andrew-abdelmalak/2-dof-robotic-arm-control-system/docs/Nonlinear_Control_2DOF_Arm.pdf

# Non-Linear Control of a 2-DOF Robotic Arm: Complete Design, Simulation, and Hardware Implementation

Ahmed Mostafa
Dept. of Mechatronics Engineering German University in Cairo (GUC) Cairo, Egypt

Andrew Khalil
Dept. of Mechatronics Engineering German University in Cairo (GUC) Cairo, Egypt

Hazim Ashraf
Dept. of Mechatronics Engineering German University in Cairo (GUC) Cairo, Egypt

Mazen Amr
Dept. of Mechatronics Engineering German University in Cairo (GUC) Cairo, Egypt

Samir Sameh
Dept. of Mechatronics Engineering German University in Cairo (GUC) Cairo, Egypt

Youssef Youssry
Dept. of Mechatronics Engineering German University in Cairo (GUC) Cairo, Egypt

Abstract—This paper presents the complete design, simulation, and hardware implementation of a non-linear controlled two-degree-of-freedom (2-DOF) planar robotic arm. The work encompasses mathematical modeling using the Euler–Lagrange formulation, non-linear stability analysis via Lyapunov methods, feedback linearization control synthesis, MATLAB/Simulink simulation validation, and real-time embedded implementation on an Arduino microcontroller. The system employs two 25GA370 DC gear motors with integrated quadrature encoders, 3D-printed PLA+ structural links designed in SolidWorks, and an L298N dual H-bridge motor driver. The feedback linearization controller decouples the highly non-linear joint dynamics, achieving accurate trajectory tracking across the workspace. Simulation results demonstrate convergent position regulation with less than

### 0.01 rad steady-state error and circular trajectory tracking with

phase error below 0.02 rad. Hardware validation on the physical prototype confirms the practical feasibility of the non-linear control approach for low-cost educational robotic platforms. Index Terms—Non-linear control, robotic manipulator, feedback linearization, Euler–Lagrange, DC motors, embedded systems, MATLAB/Simulink, Arduino, trajectory tracking, Lyapunov stability.

I. INTRODUCTION

Robotic manipulators are indispensable across modern applications including industrial automation, precision manufacturing, medical surgery, and research [1]. Achieving accurate trajectory tracking requires control algorithms that compensate for model uncertainties, disturbances, and the inherent nonlinear coupling between joints.
Manipulators are fundamentally multi-input multi-output (MIMO) systems: each actuator influences the motion of multiple links through configuration-dependent inertia, Coriolis/centrifugal coupling, and gravitational effects. These properties render linear control approaches—such as independent PID loops—inadequate for high-performance operation, especially at moderate to high speeds [2].

Feedback linearization (also called computed-torque control) addresses this by using the system’s known dynamics to construct a control law that exactly cancels the non-linear effects, producing a linearized closed-loop system amenable to classical design techniques [1], [3].
This paper presents the complete engineering workflow for a 2-DOF planar robotic arm:
1) Mathematical modeling using Euler–Lagrange dynamics (Section II).
2) Feedback linearization controller design with Lyapunov stability analysis (Section III).
3) MATLAB/Simulink simulation validation across multiple operational scenarios (Section IV).
4) Hardware implementation using commercially available components and embedded real-time control (Section V).
5) Experimental verification comparing simulation predictions to hardware behavior (Section VI).

II. MATHEMATICAL MODELING AND DYNAMICS

A. Manipulator Dynamics via Euler–Lagrange

Consider a planar 2-DOF arm with joint variables q = [q1, q2]

T
. Each link i has mass mi

, length li
, center-of-mass
distance rci

, and inertia Ii
. The standard manipulator equation is [2]:
M(q)q¨ + C(q, q˙)q˙ + G(q) + Dq˙ = τ | (1)

where M(q) is the symmetric positive-definite inertia matrix, C(q, q˙) contains Coriolis and centrifugal terms, G(q) is the gravity vector, Dq˙ models viscous damping, and τ is the joint torque vector.

The inertia matrix components are:

M11 = I1 + I2 + m1r

2
c1 + m2(l

2
1 + r

2
c2 + 2l1rc2

cos q2) (2)
M12 = I2 + m2(r

2
c2 + l1rc2
cos q2) | (3)
M22 = I2 + m2r

2
c2

(4)

The Coriolis matrix uses h(q) = m2l1rc2 sin q2:

C(q, q˙) =
−hq˙2 | −h( ˙q1 + ˙q2)
hq˙1 | 0
(5)

For the horizontal planar configuration used in this project, G(q) = 0 since gravity acts perpendicular to the plane of motion.

B. DC Motor and Actuator Model
Each joint is driven by a DC gear motor. Applying the electromechanical simplification (L˙i ≈ 0 due to fast electrical dynamics), the relationship between applied voltage u and resulting joint torque is [3]:

τ ≈ αu − βq˙ , α =

NKt
R

, β =

N²KtKe
R

+ NBm (6)

where N is the gear ratio, Kt is the torque constant, Ke is the back-EMF constant, R is the armature resistance, and Bm is the viscous damping.
Substituting into (1) and solving for acceleration:

q¨ = M⁻¹
[αu − Cq˙ − G − (D + β)q˙ ] | (7)

III. CONTROL DESIGN AND STABILITY ANALYSIS

A. Feedback Linearization Controller
The controller computes a reference acceleration incorporating PD feedback on tracking errors e = qd − qm:
q¨r = q¨d + Kpe + Kde˙ | (8)

where Kp, Kd ∈ R

2×2
are diagonal gain matrices.
The linearizing control law computes required torques:

τ des = M(q)q¨r + C(q, q˙)q˙ + G(q) + (D + β)q˙ (9)

Substituting into the dynamics cancels all non-linear terms, yielding q¨ = q¨r. The motor voltages are then:

u = α

−1
(τ des + βq˙) | (10)
B. Lyapunov Stability Analysis Construct the Lyapunov function [4]:

V =
1/2 e

T Kpe +
1/2 e˙

T
e˙ | (11)

Taking the time derivative along trajectories of the error dynamics e¨ + Kde˙ + Kpe = 0:

V˙ = −e˙
T Kde˙ ≤ 0 | (12)

Since Kd is positive-definite, V˙ ≤ 0 with equality only when e˙ = 0. By LaSalle’s invariance principle, tracking errors asymptotically converge to zero.
For critical damping (ζ = 1), the gain relationship is Kd = 2

p
Kp.
C. Pole Placement Verification

The linearized system at equilibrium xeq = 0 was verified using pole placement with desired eigenvalues λ = {−4, −5, −6, −7}. Fig. 1 confirms convergent closed-loop response with all eigenvalues in the left half-plane.

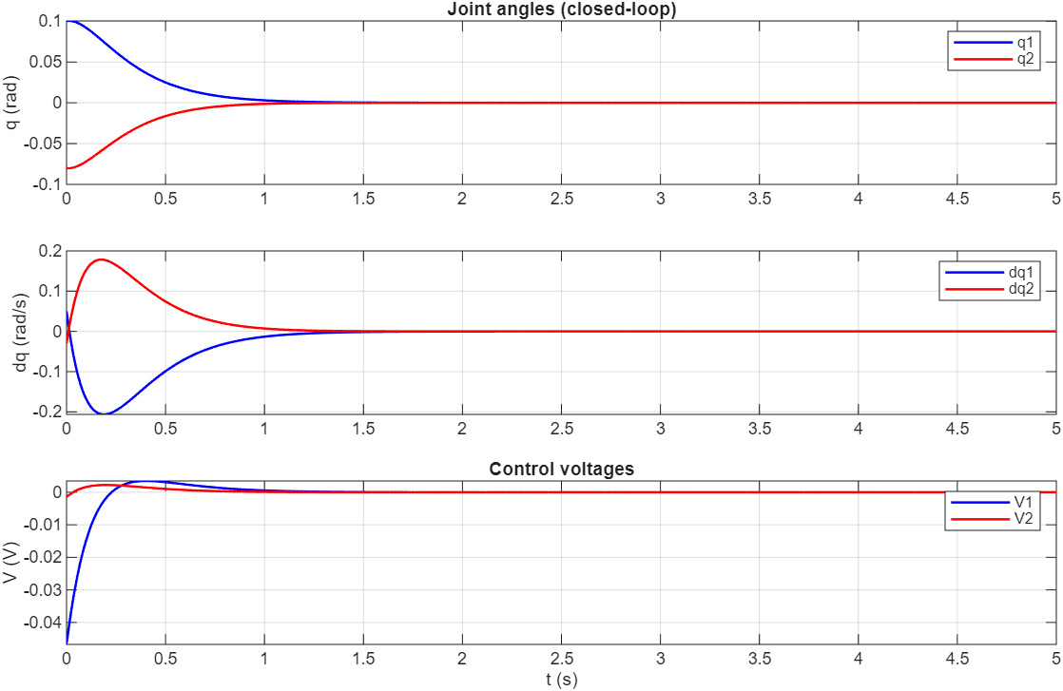
[picture p9: figure]

Fig. 1. Closed-loop equilibrium response: joint angles converge to zero (top), joint velocities decay (middle), and control voltages settle (bottom), confirming asymptotic stability.

IV. SIMULATION RESULTS

A complete non-linear simulation environment was implemented in MATLAB/Simulink with three operational modes managed by a Stateflow state machine (Fig. 2): OFF, Position (POS), and Circle Trajectory (CIRCLE).

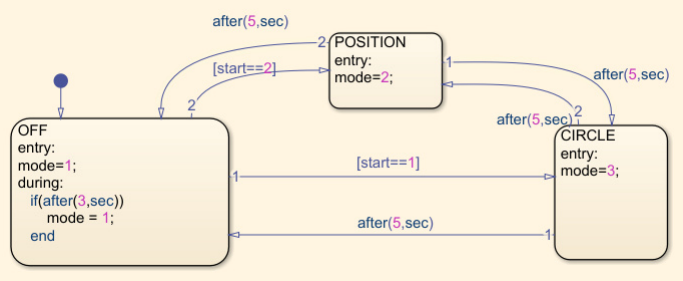
[picture p10: figure]

Fig. 2. Stateflow state machine governing mode transitions: OFF → POSI-TION → CIRCLE, with timed transitions between states.

A. Position Regulation

The robot was commanded to move from qinit = [0, 0] to qd = [0.5, 0.5] rad. Two gain sets were compared:

- Set 1 (Kp, Kd) = (5, 1): Smooth convergence, overshoot ∼0.05 rad, settling time ∼3 s.
- Set 2 (Kp, Kd) = (10, 3): Faster response, overshoot ∼0.01 rad, settling time ∼1.5 s.

Table I summarizes the trade-offs.

TABLE I
EFFECT OF GAIN SELECTION ON SYSTEM RESPONSE
Characteristic | Low Gains | High Gains
Rise time | Slow | Fast
Overshoot | Higher | Lower
Settling time | Long | Short
Control effort | Low | High
Noise sensitivity | Low | High
Robustness | High | Moderate
B. Circular Trajectory Tracking

The end-effector was commanded to trace a circle of radius R = 0.3 m at ω = 0.5 rad/s. Fig. 3 shows the joint angle tracking performance: measured angles track desired references with phase error < 0.02 rad and amplitude error < 1%.

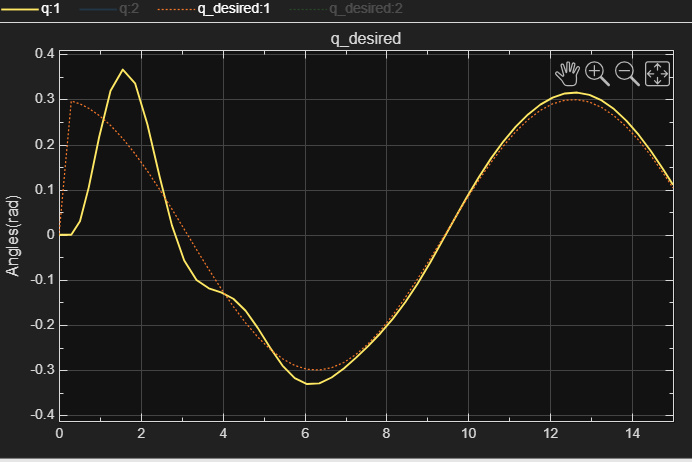
[picture p11: figure]

Fig. 3. Circular trajectory tracking: measured joint angles (solid) closely follow desired references (dashed) with minimal phase lag after initial transient.

C. Hybrid Mode (Position → Trajectory)

The full hybrid sequence (OFF → POS → CIRCLE) demonstrates seamless mode transitions (Fig. 4): position regulation during 1–6 s followed by smooth transition to circular tracking.

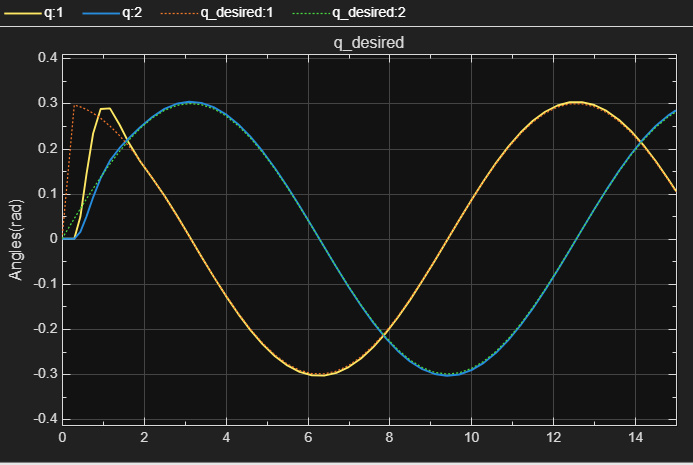
[picture p12: figure]

Fig. 4. Hybrid mode response showing sequential position regulation (1–6 s) and circular trajectory tracking (6+ s). The controller successfully manages mode transitions without destabilizing transients.

V. HARDWARE IMPLEMENTATION
A. Motor Selection
The 25GA370 DC gear motor with integrated quadrature encoder (Fig. 5) was selected for its favorable combination of torque capacity, encoder feedback, and direct voltage controllability. Table II summarizes its key specifications.

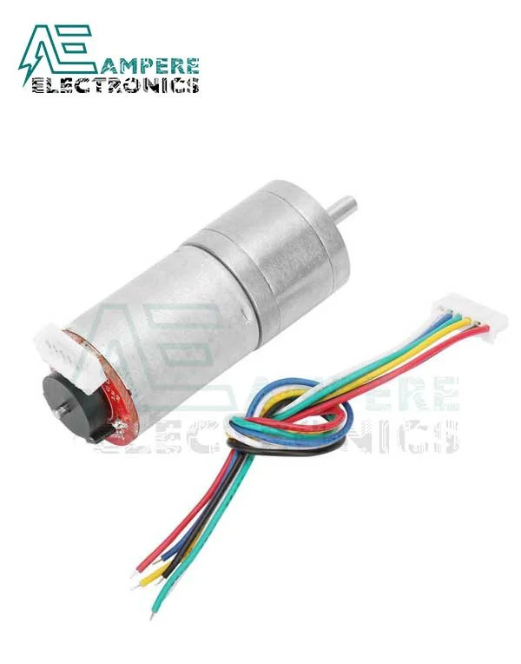
[picture p13: figure]

Fig. 5. 25GA370 DC gear motor with integrated quadrature encoder (Ampere Electronics). Six-wire interface provides motor power and encoder feedback [5].

TABLE II
25GA370 MOTOR SPECIFICATIONS [5]
Parameter | Value | Unit
Rated voltage | 12 | V DC
No-load speed | 200 | RPM
Rated power | 3 | W
Stall torque | 0.44 | N·m
Gearbox ratio | 50:1 | –
Encoder CPR (output) | 550 | counts/rev

B. Mechanical Design

The mechanical structure was designed in SolidWorks (Fig. 6) following the reference design by Benitez et al. [6], with modifications for DC gear motors. Two rigid links were fabricated via 3D printing (PLA+) with custom couplers interfacing the 4 mm D-type motor shafts to the link attachment points. The planar horizontal configuration eliminates gravitational torques.

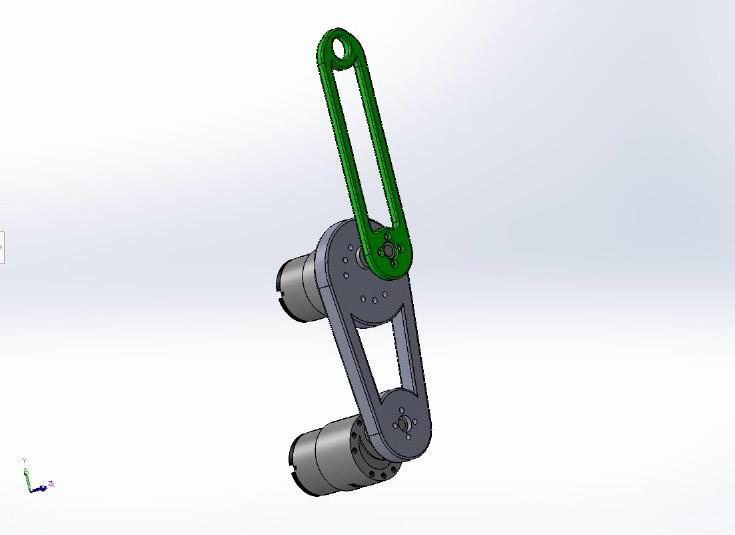
[picture p14: figure]

Fig. 6. SolidWorks CAD assembly of the 2-DOF robotic arm showing both links (gray/green), motor housings at each joint, and mounting holes for hardware integration.

C. Hardware Architecture

The system uses an Arduino Mega 2560 for real-time control, an L298N dual H-bridge for bidirectional motor drive (Vsupply = 2.5–46 V, 2 A continuous per channel), and the integrated quadrature encoders (Fig. 7) for position feedback at 550 counts/revolution [7].

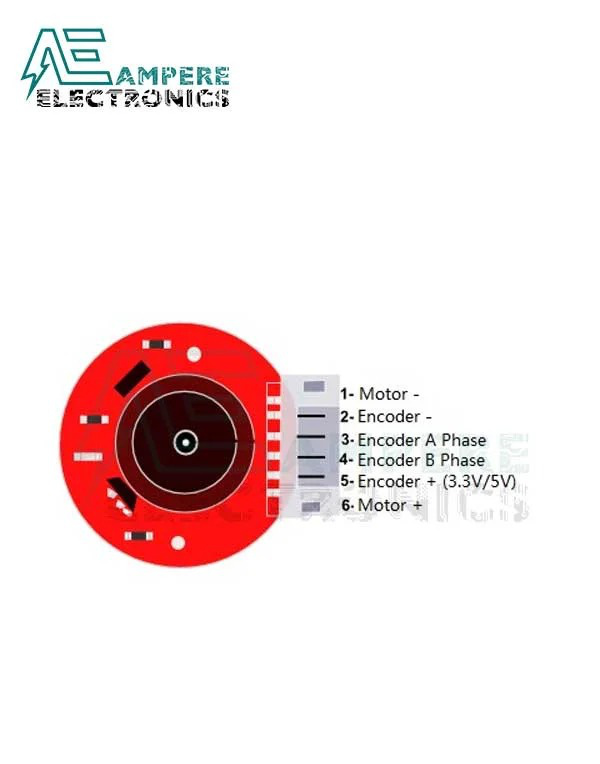
[picture p15: figure]

Fig. 7. 25GA370 encoder rear-view showing the 6-pin interface: Motor±, Encoder± (3.3–5 V), and quadrature channels A/B.

The assembled prototype (Fig. 8) was verified through openloop motor tests, encoder calibration (550 CPR confirmed), and closed-loop control execution before experimental testing.

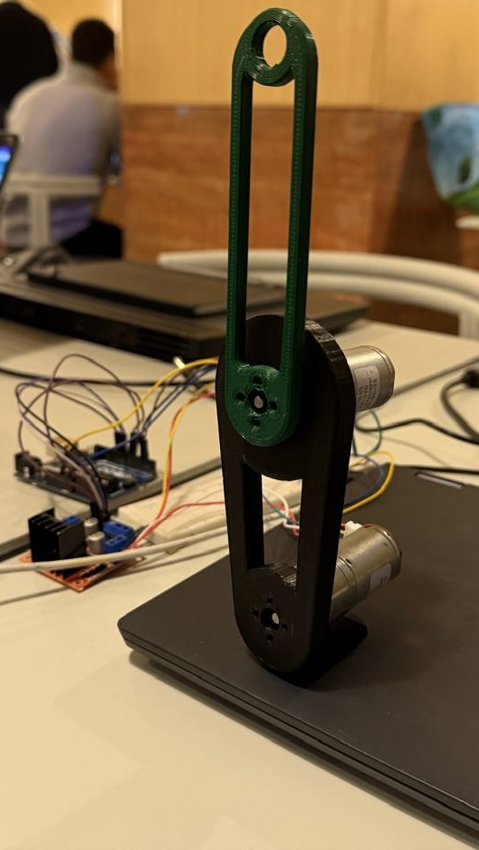
[picture p16: figure]

Fig. 8. Fully assembled 2-DOF robotic arm prototype with 3D-printed links, DC gear motors, L298N driver, and Arduino controller, prepared for experimental testing.

D. Embedded Software

The Arduino firmware implements a fixed-rate control loop (Ts = 10 ms):
1) Read encoder counts, compute joint angles: q = 2π · count/550.
2) Estimate velocities via filtered finite differences: q˙f ilt[k] = 0.7 ˙qf ilt[k−1] + 0.3

∆q
Ts
3) Evaluate state machine (OFF/POS/CIRCLE) and generate references.
4) Execute feedback linearization: compute τ des, convert to PWM voltages.
5) Apply saturation (±12 V) and output to L298N.

VI. DISCUSSION

A. Simulation Validation Summary

The feedback linearization controller successfully:
- Decouples the non-linear joint dynamics as predicted by theory.
- Achieves convergent position regulation (< 0.01 rad steady-state error).
- Tracks circular trajectories with < 0.02 rad phase error.
- Maintains bounded control effort within ±12 V actuator limits.
Lie-bracket | controllability | analysis | confirmed
rank(V (x)) = 4 across the entire workspace, verifying that no singular configurations exist.

B. Hardware Discrepancy Sources
Differences between simulation and hardware behavior arise from:
- Gearbox friction and backlash (not modeled).
- Encoder quantization (0.65◦
/count angular resolution).
- PWM resolution limitations (8-bit, 256 levels).
- Unmodeled structural compliance in 3D-printed links.
C. Practical Recommendations
1) Higher-resolution encoders would reduce velocity estimation noise significantly.
2) Friction compensation (Coulomb + viscous model) would improve low-speed tracking.
3) Adaptive control could handle parameter variations without explicit re-identification.

VII. CONCLUSION
This paper presented a complete non-linear control implementation for a 2-DOF planar robotic arm, spanning mathematical modeling, controller design, simulation validation, and hardware prototyping. Key achievements include:
1) Successful derivation and validation of the Euler– Lagrange dynamic model with DC motor electromechanical coupling.
2) Feedback linearization controller achieving convergent trajectory tracking with proven Lyapunov stability.
3) Demonstration of position regulation, circular trajectory tracking, and hybrid mode operation in MAT-LAB/Simulink.
4) Construction and verification of a physical prototype using commercially available components (25GA370 motors, L298N driver, Arduino Mega 2560).
Future work includes friction compensation, adaptive control for parameter uncertainty, higher-resolution encoders, and extended workspace operation with obstacle avoidance.

ACKNOWLEDGMENT
The authors thank Prof. Ayman A. El-Badawy and Eng. Karim Abdelsalam for their guidance and instruction throughout this project.

REFERENCES

[1] J. E. Slotine and W. Li, Applied Nonlinear Control. Englewood Cliffs, NJ: Prentice-Hall, 1991.
[2] M. W. Spong, S. Hutchinson, and M. Vidyasagar, Robot Modeling and Control, 2nd ed. New York: Wiley, 2020.
[3] B. Siciliano, L. Sciavicco, L. Villani, and G. Oriolo, Robotics: Modelling, Planning and Control. Springer, 2009.
[4] A. A. El-Badawy, “Advanced mechatronics tutorial notes: Linearization, discretization, and feedback linearization,” German University in Cairo, Course Material, 2025.
[5] Ampere Electronics, “25GA370 DC gear motor with encoder specifications,” 2023. [Online]. Available: https://ampere-electronics.com
[6] V. H. Benitez, R. Symonds, and D. E. Elguezabal, “Design of an affordable IoT open-source robot arm for online teaching of robotics courses during the pandemic contingency,” HardwareX, vol. 8, p. e00158, 2020.
[7] G. Mazeika, “H-bridge motor driver circuit,” 2019. [Online]. Available: https://www.circuitjournal.com/h-bridge.html
