andrew-abdelmalak/2-dof-robotic-arm-control-system/(commit log)

2026-03-18 Polish repo for publication
    - Enrich README with data from IEEE paper: formal dynamics equations,
    feedback linearization controller, Lyapunov stability proof, simulation
    results tables, hardware specs, embedded control loop description
    - Extract and embed 8 figures from the report (prototype, CAD, motor,
    encoder, equilibrium response, stateflow, circular tracking, gain comparison)
    - Fix author names (Abdelmalak, Alwakad, Yacoub)
    - Add acknowledgments section (Prof. El-Badawy, Eng. Abdelsalam)
    - Add references section (6 citations from the paper)
    - Add license/MATLAB/Arduino badges
    - Update repo structure tree to include docs/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
2026-03-18 Standardize repository structure: Add badges, TOC, and improve .gitignore
    - Add Python badge to README.md for language discovery
    - Add Table of Contents for improved navigation
    - Expand .gitignore to 7-section standard format (OS/IDE/Python/MATLAB/Arduino/Logs/Archives)
    - Aligns with standardization plan across 4 repositories
2026-11-13 build: track paper LaTeX sources and ignore LaTeX/test caches
2026-11-13 fix(arduino): add AVR compatibility shims so all four sketches compile on Mega 2560
2026-11-13 fix(matlab): remove double-added motor inertia and add GNU Octave portability
2026-11-13 docs(paper): align authors, encoder resolution, loop timing, and trajectory captions with code
2026-11-13 ci: replace lint placeholder with full Python, Octave, Arduino, and LaTeX CI
