andrew-abdelmalak/2-dof-robotic-arm-control-system/(notices)

Notices in the files:
README.md:
License: MIT
